danny-andersen/PiClusterCase-Fan-Controller/README.md

# PiClusterCase-Fan-Controller
Raspberry PI and Arduino project to control 4 fans on a 8 slot pi case
