danny-andersen/PiClusterCase-Fan-Controller/mainboard-vero.pdf

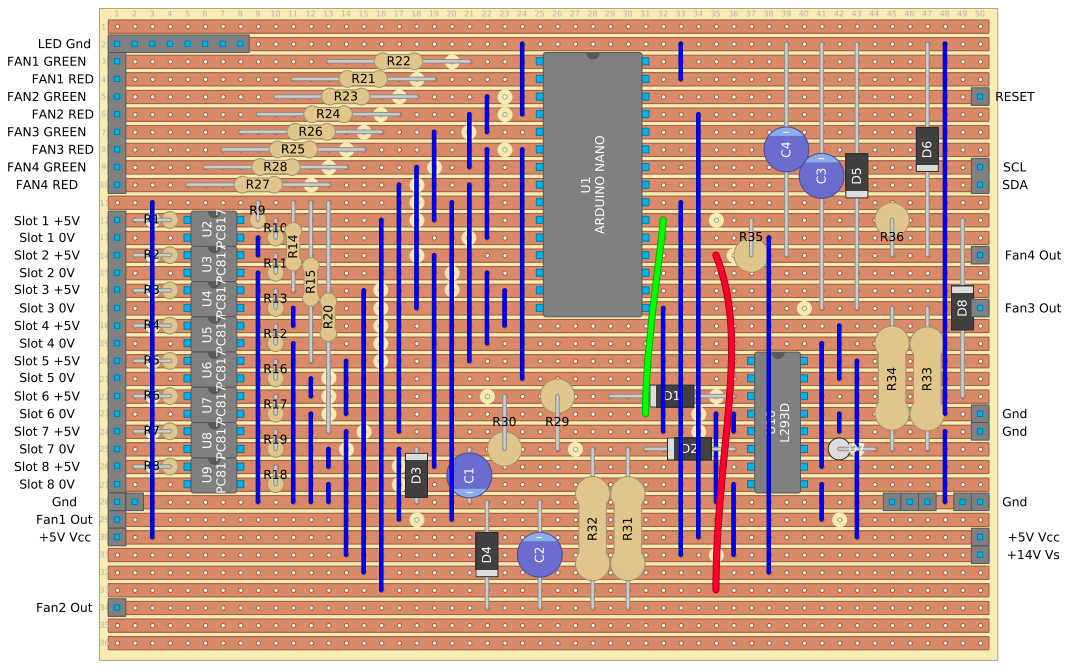
[picture p1: page 1]
