danny-andersen/PiClusterCase-Fan-Controller/Mainboard-Circuit-Diagram.pdf

# FAN3 G R

# FAN2 G R

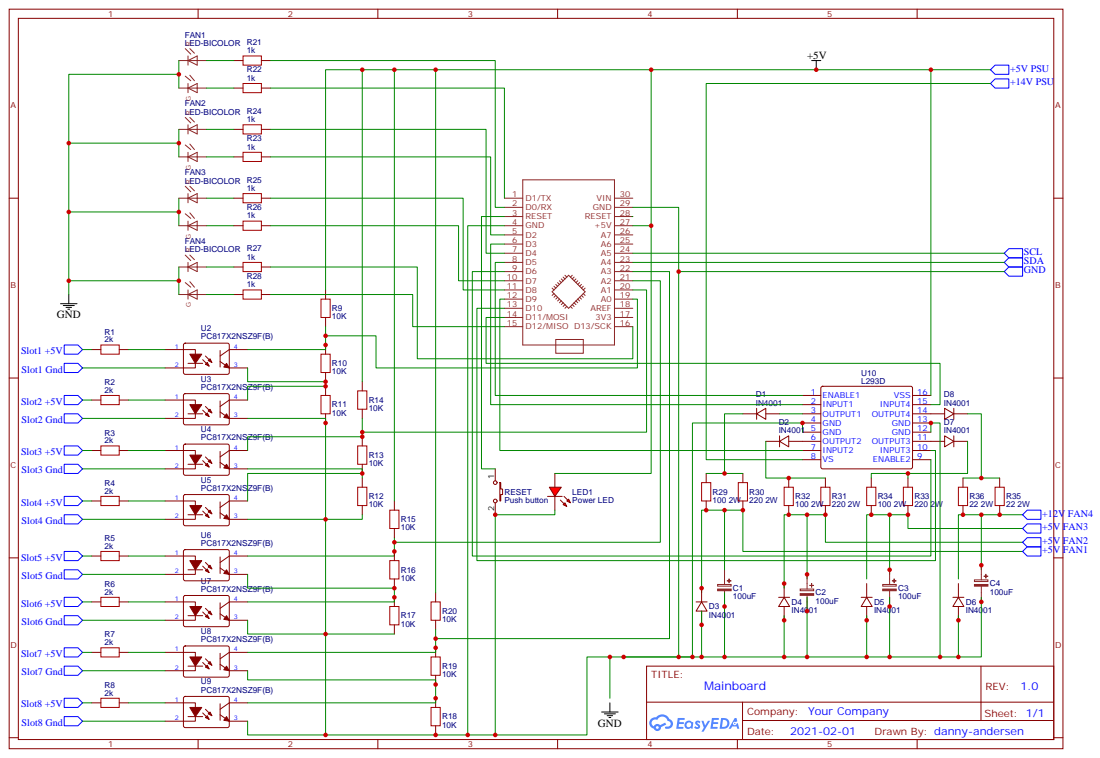
[picture p2: page 1]

Drawn By: danny-andersen
