danny-andersen/PiClusterCase-Fan-Controller/mainboard-vero-cutouts.pdf

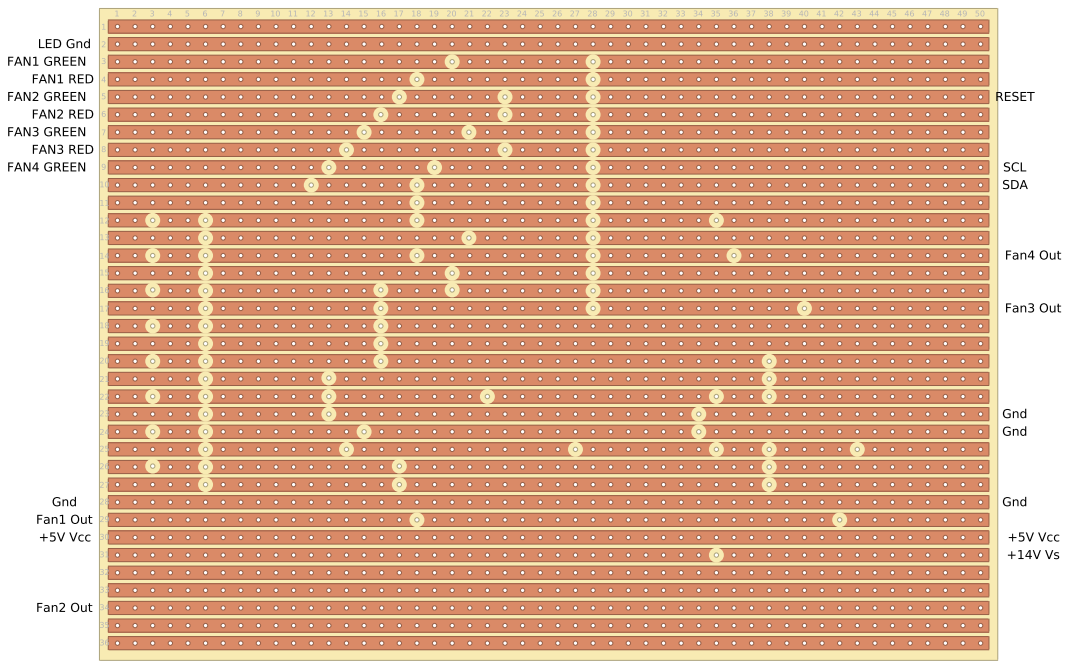
[picture p3: page 1]
