danny-andersen/PiClusterCase-Fan-Controller/mainboard-vero-bare.pdf

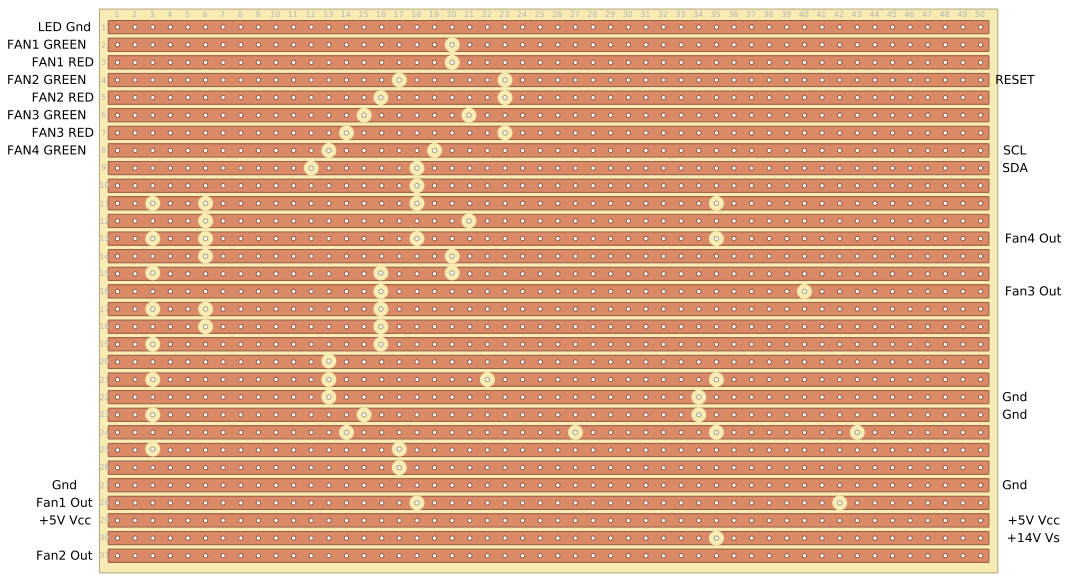
[picture p4: page 1]
