danny-andersen/PiClusterCase-Fan-Controller/fanSpeed.ini

[hosts]
slot1=EMPTY
slot2=pi4node2
slot3=EMPTY
slot4=pi4node1
slot5=EMPTY
slot6=pi4node0
slot7=EMPTY
slot8=pi4desktop

[fans]
slot1=1
slot2=1
slot3=2
slot4=2
slot5=3
slot6=3
slot7=4
slot8=4

[comms]
channel = 1
#  Arduino will be addr 0x10
address = 0x10
# Msg start and end bytes
startMsg = 240
endMsg = 250
#Value if no fan speed
noFanSpeed = 255

[fanSpeed]
#If using PWM output, this will change the fan speed
#Otherwise it just determines when the indicator LED changes from green to amber to red
#On a 5V supply:
#Note: Voltage divider reduces it to 5V
fan1MinSpeed = 60
fan1MaxSpeed = 100

fan2MinSpeed = 60
fan2MaxSpeed = 100

fan3MinSpeed = 60
fan3MaxSpeed = 100 

#12 V Fan supply 
fan4MinSpeed = 40
fan4MaxSpeed = 120

#Fan Supply voltage (expressed relative to the fan speed)
fanSupplyVoltage = 120

#PWM output - set to 1 if the Fan can take PWM voltage, 
#otherwise set to 0 so the fan is either driven on or off
pwmOutput = 1
#Temp to turn fan off at
offTemp = 52.0
#Temp to turn fan back on at min speed
minTemp = 60.0
#Temp at which to set fans at max speed
maxTemp = 80.0

[localResultFiles]
resultLocation = /data/logs/host-temp/


[shell]
userName = danny
tempCommand = sudo vcgencmd measure_temp
tempResultFormat = temp={:f}'C
 
