danny-andersen/PiClusterCase-Fan-Controller/(commit log)

2021-01-24 First check in - uses PWM output
2021-01-24 Added selectable pwm mode
2021-01-25 Send range with speeds so that indicator is correct
    [fan-controller.ino, fanSpeed.ini, sendFanSpeed.py]
2021-01-25 Arduino ino editor + uploader config
2021-01-26 Blink indicator LED if using power sensing not temp sensing
2021-01-26 Changed settings for 12V fan
2021-01-28 Fixed sending range for each fan for 5V with voltage divider
    [fan-controller.ino, fanSpeed.ini, sendFanSpeed.py]
2021-01-29 Fixed Arduino defaults
2021-01-30 Bumped up supply volts to 14 to increase dynamic range and inc 12V fan
2021-01-31 Switched to Uno board on breadboard.
2021-02-02 Added watchdog code But hw watchdog doesnt work with old bootloader so forcing a soft reset
    [fan-controller.ino]
2021-02-03 Circuit schematic
2021-02-04 First version using wrong Nano pin out sigh
2021-02-04 Corrected nano pin out
2021-02-04 Fixed resistor
2021-02-07 Changed Vero to match board size Changed flyleads to links
2021-02-07 Changed Opto resisters to 2K as not enough 1Ks
2021-02-21 Created systemd service from python script for sending fan speeds to controller
2021-07-22 Added timeout to fix issue with ssh hang on node shutdown
    [sendFanSpeed.py]
2022-02-02 Do local file check only - dont do SSH on fail
    [sendFanSpeed.py]
2022-02-18 Blink led when no temp received for a node
2025-04-21 Send fan speed to dropbox as a % of max
